marekpiotrowskimp/air-quality-lora/air_condition/enclosure/case_cover.stl

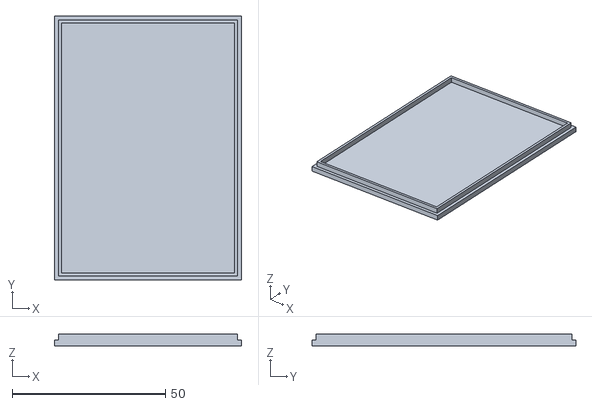
[picture p13: CAD file, 2026-11-03]
air_condition/enclosure/case_cover.stl
61.0 x 86.0 x 4.00
