marekpiotrowskimp/air-quality-lora/air_condition_receiver/enclosure/case_body_v3.stl

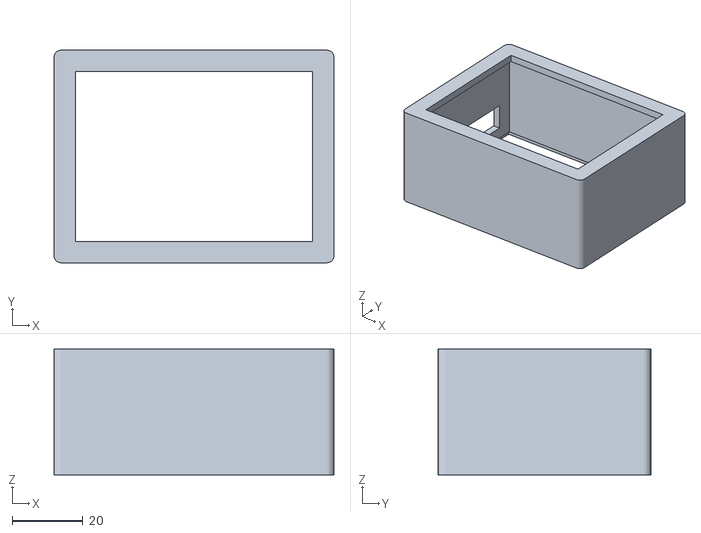
[picture p14: CAD file, 2026-11-03]
air_condition_receiver/enclosure/case_body_v3.stl
79.0 x 60.0 x 35.5
