marekpiotrowskimp/air-quality-lora/air_condition/enclosure/case_body.stl

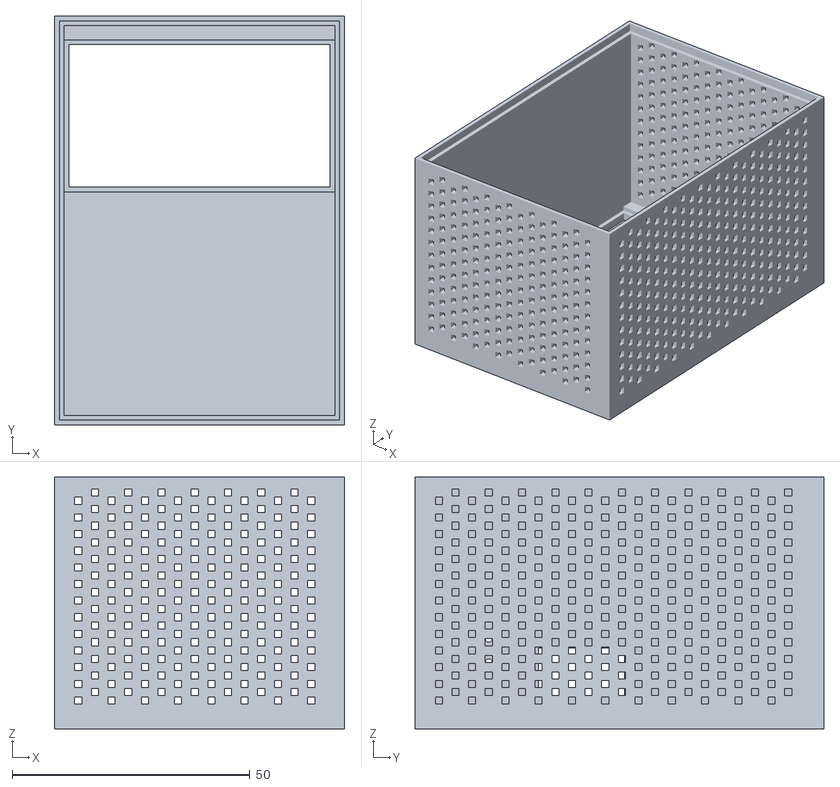
[picture p15: CAD file, 2026-11-03]
air_condition/enclosure/case_body.stl
61.0 x 86.0 x 53.0
