marekpiotrowskimp/air-quality-lora/air_condition_receiver/enclosure/case_body.stl

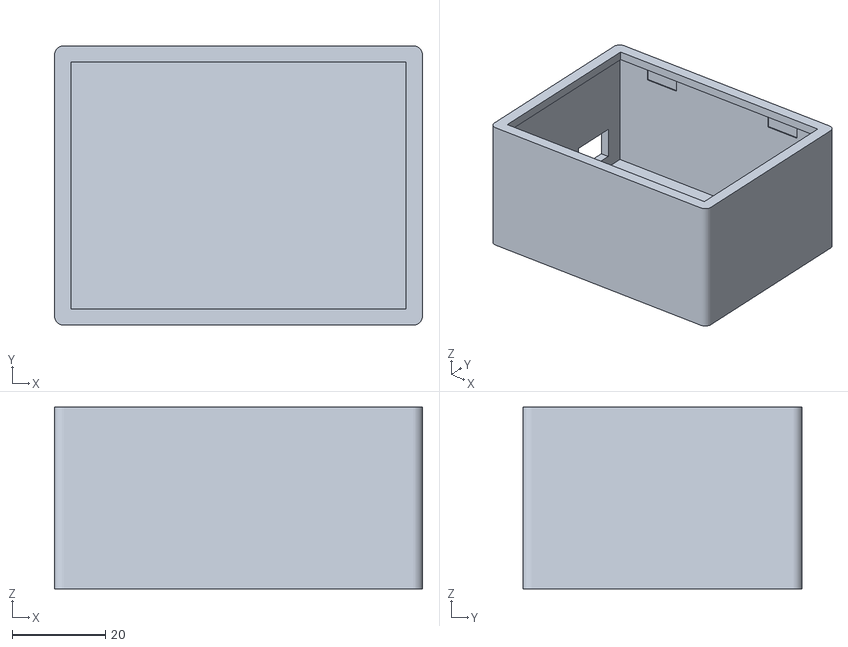
[picture p16: CAD file, 2026-11-03]
air_condition_receiver/enclosure/case_body.stl
79.0 x 60.0 x 39.0
