marekpiotrowskimp/air-quality-lora/air_condition_receiver/enclosure/case_cover_v3.stl

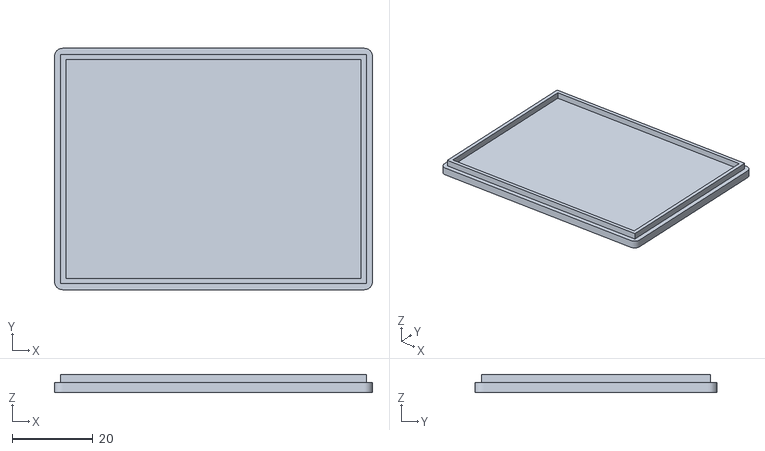
[picture p17: CAD file, 2026-11-03]
air_condition_receiver/enclosure/case_cover_v3.stl
79.0 x 60.0 x 4.50
