marekpiotrowskimp/air-quality-lora/air_condition_receiver/enclosure/case_frame.stl

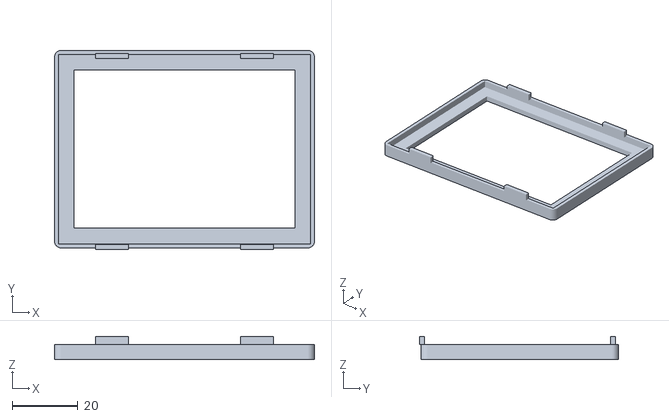
[picture p18: CAD file, 2026-11-03]
air_condition_receiver/enclosure/case_frame.stl
79.0 x 60.5 x 7.00
