marekpiotrowskimp/air-quality-lora/air_condition_epaper/splash_bitmap.h

/*
 * Splash screen bitmap - Air Quality icon
 * 296x128 pixels, 1-bit monochrome
 * 
 * Design: Stylized lungs/air flow pattern with cityscape silhouette
 */

#ifndef SPLASH_BITMAP_H
#define SPLASH_BITMAP_H

#ifdef __AVR__
  #include <avr/pgmspace.h>
#elif defined(ESP32) || defined(ESP8266)
  #include <pgmspace.h>
#endif

// Lung icon 64x64 pixels - centered on screen
// Simple outline design that looks good on e-paper
const unsigned char lung_icon_64x64[] PROGMEM = {
  0x00, 0x00, 0x00, 0x00, 0x00, 0x00, 0x00, 0x00,
  0x00, 0x00, 0x00, 0x18, 0x18, 0x00, 0x00, 0x00,
  0x00, 0x00, 0x00, 0x18, 0x18, 0x00, 0x00, 0x00,
  0x00, 0x00, 0x00, 0x18, 0x18, 0x00, 0x00, 0x00,
  0x00, 0x00, 0x00, 0x18, 0x18, 0x00, 0x00, 0x00,
  0x00, 0x00, 0x00, 0x3C, 0x3C, 0x00, 0x00, 0x00,
  0x00, 0x00, 0x00, 0x3C, 0x3C, 0x00, 0x00, 0x00,
  0x00, 0x00, 0x00, 0x7E, 0x7E, 0x00, 0x00, 0x00,
  0x00, 0x00, 0x00, 0x7E, 0x7E, 0x00, 0x00, 0x00,
  0x00, 0x03, 0xC0, 0xFF, 0xFF, 0x03, 0xC0, 0x00,
  0x00, 0x0F, 0xF0, 0xFF, 0xFF, 0x0F, 0xF0, 0x00,
  0x00, 0x1F, 0xF8, 0x7E, 0x7E, 0x1F, 0xF8, 0x00,
  0x00, 0x3F, 0xFC, 0x3C, 0x3C, 0x3F, 0xFC, 0x00,
  0x00, 0x7F, 0xFE, 0x3C, 0x3C, 0x7F, 0xFE, 0x00,
  0x00, 0xFF, 0xFF, 0x18, 0x18, 0xFF, 0xFF, 0x00,
  0x01, 0xFF, 0xFF, 0x18, 0x18, 0xFF, 0xFF, 0x80,
  0x01, 0xFF, 0xFF, 0x00, 0x00, 0xFF, 0xFF, 0x80,
  0x03, 0xFC, 0x3F, 0x00, 0x00, 0xFC, 0x3F, 0xC0,
  0x03, 0xF8, 0x1F, 0x00, 0x00, 0xF8, 0x1F, 0xC0,
  0x07, 0xF0, 0x0F, 0x00, 0x00, 0xF0, 0x0F, 0xE0,
  0x07, 0xE0, 0x07, 0x00, 0x00, 0xE0, 0x07, 0xE0,
  0x0F, 0xE0, 0x07, 0x00, 0x00, 0xE0, 0x07, 0xF0,
  0x0F, 0xC0, 0x03, 0x00, 0x00, 0xC0, 0x03, 0xF0,
  0x0F, 0xC0, 0x03, 0x00, 0x00, 0xC0, 0x03, 0xF0,
  0x1F, 0x80, 0x01, 0x80, 0x01, 0x80, 0x01, 0xF8,
  0x1F, 0x80, 0x01, 0x80, 0x01, 0x80, 0x01, 0xF8,
  0x1F, 0x80, 0x01, 0x80, 0x01, 0x80, 0x01, 0xF8,
  0x1F, 0x00, 0x00, 0xC0, 0x03, 0x00, 0x00, 0xF8,
  0x1F, 0x00, 0x00, 0xC0, 0x03, 0x00, 0x00, 0xF8,
  0x1F, 0x00, 0x00, 0xC0, 0x03, 0x00, 0x00, 0xF8,
  0x1F, 0x00, 0x00, 0x60, 0x06, 0x00, 0x00, 0xF8,
  0x1F, 0x00, 0x00, 0x60, 0x06, 0x00, 0x00, 0xF8,
  0x1F, 0x00, 0x00, 0x60, 0x06, 0x00, 0x00, 0xF8,
  0x1F, 0x00, 0x00, 0x30, 0x0C, 0x00, 0x00, 0xF8,
  0x1F, 0x00, 0x00, 0x30, 0x0C, 0x00, 0x00, 0xF8,
  0x1F, 0x00, 0x00, 0x30, 0x0C, 0x00, 0x00, 0xF8,
  0x1F, 0x00, 0x00, 0x18, 0x18, 0x00, 0x00, 0xF8,
  0x1F, 0x00, 0x00, 0x18, 0x18, 0x00, 0x00, 0xF8,
  0x1F, 0x00, 0x00, 0x18, 0x18, 0x00, 0x00, 0xF8,
  0x1F, 0x00, 0x00, 0x0C, 0x30, 0x00, 0x00, 0xF8,
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
};

#define LUNG_ICON_WIDTH 64
#define LUNG_ICON_HEIGHT 64

#endif // SPLASH_BITMAP_H
